yasinalp/SelfBulance/vivado/ip_repo/distance_sensor/readme.md

This IP sends a trigger signal to the distance sensors and waits for echo signals. Time elapsed from the rising edge of echo to the falling edge for each sensor is converted to distance values.
