yasinalp/SelfBulance/vivado/ip_repo/dc_motor_driver/readme.md

This IP takes an action as an input and selects appropriate pwm signals for each action.
