yasinalp/SelfBulance/design_1.pdf

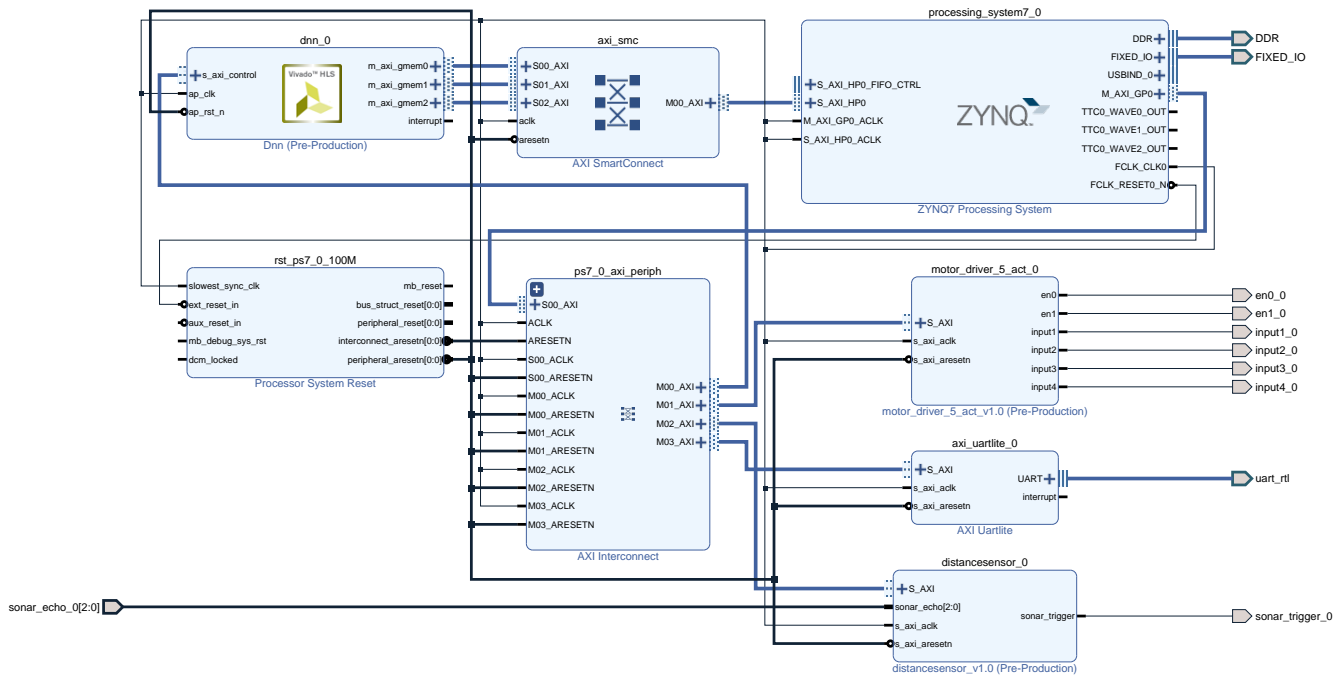
[picture p19: page 1]
DDR FIXED_IO; axi_smc; AXI SmartConnect; S00_AXI; S01_AXI; S02_AXI; M00_AXI; aclk; aresetn; axi_uartlite_0; AXI Uartlite; S_AXI; UART; s_axi_aclk; s_axi_aresetn; interrupt; distancesensor_0; distancesensor_v1.0 (Pre-Production); sonar_trigger; sonar_echo[2:0]; dnn_0; s_axi_control; m_axi_gmem0; m_axi_gmem1; m_axi_gmem2; ap_clk; ap_rst_n; en0_0 en1_0 input1_0 input2_0 input3_0 input4_0; motor_driver_5_act_0; motor_driver_5_act_v1.0 (Pre-Production); input1; input2; input3; input4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

Dnn (Pre-Production)

Processor System Reset
