yasinalp/SelfBulance/vivado/main_project/srcs/constraints/constraint_1.xdc

set_property IOSTANDARD LVCMOS33 [get_ports uart_rtl_rxd]
set_property IOSTANDARD LVCMOS33 [get_ports uart_rtl_txd]
set_property IOSTANDARD LVCMOS33 [get_ports {sonar_echo_0[0]}]
set_property IOSTANDARD LVCMOS33 [get_ports {sonar_echo_0[1]}]
set_property IOSTANDARD LVCMOS33 [get_ports {sonar_echo_0[2]}]
set_property PACKAGE_PIN Y10 [get_ports {sonar_echo_0[0]}]
set_property PACKAGE_PIN AA11 [get_ports {sonar_echo_0[1]}]
set_property PACKAGE_PIN Y11 [get_ports {sonar_echo_0[2]}]
set_property PACKAGE_PIN W12 [get_ports en0_0]
set_property PACKAGE_PIN V12 [get_ports en1_0]
set_property PACKAGE_PIN W11 [get_ports input1_0]
set_property PACKAGE_PIN V10 [get_ports input2_0]
set_property PACKAGE_PIN W10 [get_ports input3_0]
set_property PACKAGE_PIN V9 [get_ports input4_0]
set_property PACKAGE_PIN AA9 [get_ports sonar_trigger_0]
set_property PACKAGE_PIN W8 [get_ports uart_rtl_rxd]
set_property PACKAGE_PIN V8 [get_ports uart_rtl_txd]
set_property IOSTANDARD LVCMOS33 [get_ports en0_0]
set_property IOSTANDARD LVCMOS33 [get_ports en1_0]
set_property IOSTANDARD LVCMOS33 [get_ports input1_0]
set_property IOSTANDARD LVCMOS33 [get_ports input2_0]
set_property IOSTANDARD LVCMOS33 [get_ports input3_0]
set_property IOSTANDARD LVCMOS33 [get_ports input4_0]
set_property IOSTANDARD LVCMOS33 [get_ports sonar_trigger_0]
