yasinalp/SelfBulance/vivado/ip_repo/dc_motor_driver/dc_motor_driver_v1_0.vhd

library ieee;
use ieee.std_logic_1164.all;
use ieee.numeric_std.all;

entity dc_motor_driver_v1_0 is
	generic (
		-- Users to add parameters here
		pwm_0_l : integer := 100000;
        pwm_0_r : integer := 100000;
        pwm_1_l : integer := 1000;
        pwm_1_r : integer := 100000;
        pwm_2_l : integer := 100000;
        pwm_2_r : integer := 1000;
		-- User parameters ends
		-- Do not modify the parameters beyond this line


		-- Parameters of Axi Slave Bus Interface S_AXI
		C_S_AXI_DATA_WIDTH	: integer	:= 32;
		C_S_AXI_ADDR_WIDTH	: integer	:= 4
	);
	port (
		-- Users to add ports here
        en0, en1, input1, input2, input3, input4 : out std_logic;
		-- User ports ends
		-- Do not modify the ports beyond this line


		-- Ports of Axi Slave Bus Interface S_AXI
		s_axi_aclk	: in std_logic;
		s_axi_aresetn	: in std_logic;
		s_axi_awaddr	: in std_logic_vector(C_S_AXI_ADDR_WIDTH-1 downto 0);
		s_axi_awprot	: in std_logic_vector(2 downto 0);
		s_axi_awvalid	: in std_logic;
		s_axi_awready	: out std_logic;
		s_axi_wdata	: in std_logic_vector(C_S_AXI_DATA_WIDTH-1 downto 0);
		s_axi_wstrb	: in std_logic_vector((C_S_AXI_DATA_WIDTH/8)-1 downto 0);
		s_axi_wvalid	: in std_logic;
		s_axi_wready	: out std_logic;
		s_axi_bresp	: out std_logic_vector(1 downto 0);
		s_axi_bvalid	: out std_logic;
		s_axi_bready	: in std_logic;
		s_axi_araddr	: in std_logic_vector(C_S_AXI_ADDR_WIDTH-1 downto 0);
		s_axi_arprot	: in std_logic_vector(2 downto 0);
		s_axi_arvalid	: in std_logic;
		s_axi_arready	: out std_logic;
		s_axi_rdata	: out std_logic_vector(C_S_AXI_DATA_WIDTH-1 downto 0);
		s_axi_rresp	: out std_logic_vector(1 downto 0);
		s_axi_rvalid	: out std_logic;
		s_axi_rready	: in std_logic
	);
end dc_motor_driver_v1_0;

architecture arch_imp of dc_motor_driver_v1_0 is

	-- component declaration
	component dc_motor_driver_v1_0_S_AXI is
		generic (
		pwm_0_l : integer := 100000;
        pwm_0_r : integer := 100000;
        pwm_1_l : integer := 1000;
        pwm_1_r : integer := 100000;
        pwm_2_l : integer := 100000;
        pwm_2_r : integer := 1000;
		C_S_AXI_DATA_WIDTH	: integer	:= 32;
		C_S_AXI_ADDR_WIDTH	: integer	:= 4
		);
		port (
		en0, en1, input1, input2, input3, input4 : out std_logic;
		S_AXI_ACLK	: in std_logic;
		S_AXI_ARESETN	: in std_logic;
		S_AXI_AWADDR	: in std_logic_vector(C_S_AXI_ADDR_WIDTH-1 downto 0);
		S_AXI_AWPROT	: in std_logic_vector(2 downto 0);
		S_AXI_AWVALID	: in std_logic;
		S_AXI_AWREADY	: out std_logic;
		S_AXI_WDATA	: in std_logic_vector(C_S_AXI_DATA_WIDTH-1 downto 0);
		S_AXI_WSTRB	: in std_logic_vector((C_S_AXI_DATA_WIDTH/8)-1 downto 0);
		S_AXI_WVALID	: in std_logic;
		S_AXI_WREADY	: out std_logic;
		S_AXI_BRESP	: out std_logic_vector(1 downto 0);
		S_AXI_BVALID	: out std_logic;
		S_AXI_BREADY	: in std_logic;
		S_AXI_ARADDR	: in std_logic_vector(C_S_AXI_ADDR_WIDTH-1 downto 0);
		S_AXI_ARPROT	: in std_logic_vector(2 downto 0);
		S_AXI_ARVALID	: in std_logic;
		S_AXI_ARREADY	: out std_logic;
		S_AXI_RDATA	: out std_logic_vector(C_S_AXI_DATA_WIDTH-1 downto 0);
		S_AXI_RRESP	: out std_logic_vector(1 downto 0);
		S_AXI_RVALID	: out std_logic;
		S_AXI_RREADY	: in std_logic
		);
	end component dc_motor_driver_v1_0_S_AXI;

begin

-- Instantiation of Axi Bus Interface S_AXI
dc_motor_driver_v1_0_S_AXI_inst : dc_motor_driver_v1_0_S_AXI
	generic map (
	    pwm_0_l => pwm_0_l,
        pwm_0_r => pwm_0_r,
        pwm_1_l => pwm_1_l,
        pwm_1_r => pwm_1_r,
        pwm_2_l => pwm_2_l,
        pwm_2_r => pwm_2_r,
		C_S_AXI_DATA_WIDTH	=> C_S_AXI_DATA_WIDTH,
		C_S_AXI_ADDR_WIDTH	=> C_S_AXI_ADDR_WIDTH
	)
	port map (
	    en0 => en0,
	    en1 => en1,
	    input1 => input1,
	    input2 => input2,
	    input3 => input3,
	    input4 => input4,
		S_AXI_ACLK	=> s_axi_aclk,
		S_AXI_ARESETN	=> s_axi_aresetn,
		S_AXI_AWADDR	=> s_axi_awaddr,
		S_AXI_AWPROT	=> s_axi_awprot,
		S_AXI_AWVALID	=> s_axi_awvalid,
		S_AXI_AWREADY	=> s_axi_awready,
		S_AXI_WDATA	=> s_axi_wdata,
		S_AXI_WSTRB	=> s_axi_wstrb,
		S_AXI_WVALID	=> s_axi_wvalid,
		S_AXI_WREADY	=> s_axi_wready,
		S_AXI_BRESP	=> s_axi_bresp,
		S_AXI_BVALID	=> s_axi_bvalid,
		S_AXI_BREADY	=> s_axi_bready,
		S_AXI_ARADDR	=> s_axi_araddr,
		S_AXI_ARPROT	=> s_axi_arprot,
		S_AXI_ARVALID	=> s_axi_arvalid,
		S_AXI_ARREADY	=> s_axi_arready,
		S_AXI_RDATA	=> s_axi_rdata,
		S_AXI_RRESP	=> s_axi_rresp,
		S_AXI_RVALID	=> s_axi_rvalid,
		S_AXI_RREADY	=> s_axi_rready
	);

	-- Add user logic here

	-- User logic ends

end arch_imp;
