yasinalp/SelfBulance/vivado/main_project/srcs/vhdl/design_1_wrapper.vhd

--Copyright 1986-2017 Xilinx, Inc. All Rights Reserved.
----------------------------------------------------------------------------------
--Tool Version: Vivado v.2017.4 (win64) Build 2086221 Fri Dec 15 20:55:39 MST 2017
--Date        : Sun Jun 28 14:13:44 2020
--Host        : DESKTOP-37KDSCD running 64-bit major release  (build 9200)
--Command     : generate_target design_1_wrapper.bd
--Design      : design_1_wrapper
--Purpose     : IP block netlist
----------------------------------------------------------------------------------
library IEEE;
use IEEE.STD_LOGIC_1164.ALL;
library UNISIM;
use UNISIM.VCOMPONENTS.ALL;
entity design_1_wrapper is
  port (
    DDR_addr : inout STD_LOGIC_VECTOR ( 14 downto 0 );
    DDR_ba : inout STD_LOGIC_VECTOR ( 2 downto 0 );
    DDR_cas_n : inout STD_LOGIC;
    DDR_ck_n : inout STD_LOGIC;
    DDR_ck_p : inout STD_LOGIC;
    DDR_cke : inout STD_LOGIC;
    DDR_cs_n : inout STD_LOGIC;
    DDR_dm : inout STD_LOGIC_VECTOR ( 3 downto 0 );
    DDR_dq : inout STD_LOGIC_VECTOR ( 31 downto 0 );
    DDR_dqs_n : inout STD_LOGIC_VECTOR ( 3 downto 0 );
    DDR_dqs_p : inout STD_LOGIC_VECTOR ( 3 downto 0 );
    DDR_odt : inout STD_LOGIC;
    DDR_ras_n : inout STD_LOGIC;
    DDR_reset_n : inout STD_LOGIC;
    DDR_we_n : inout STD_LOGIC;
    FIXED_IO_ddr_vrn : inout STD_LOGIC;
    FIXED_IO_ddr_vrp : inout STD_LOGIC;
    FIXED_IO_mio : inout STD_LOGIC_VECTOR ( 53 downto 0 );
    FIXED_IO_ps_clk : inout STD_LOGIC;
    FIXED_IO_ps_porb : inout STD_LOGIC;
    FIXED_IO_ps_srstb : inout STD_LOGIC;
    en0_0 : out STD_LOGIC;
    en1_0 : out STD_LOGIC;
    input1_0 : out STD_LOGIC;
    input2_0 : out STD_LOGIC;
    input3_0 : out STD_LOGIC;
    input4_0 : out STD_LOGIC;
    sonar_echo_0 : in STD_LOGIC_VECTOR ( 2 downto 0 );
    sonar_trigger_0 : out STD_LOGIC;
    uart_rtl_rxd : in STD_LOGIC;
    uart_rtl_txd : out STD_LOGIC
  );
end design_1_wrapper;

architecture STRUCTURE of design_1_wrapper is
  component design_1 is
  port (
    DDR_cas_n : inout STD_LOGIC;
    DDR_cke : inout STD_LOGIC;
    DDR_ck_n : inout STD_LOGIC;
    DDR_ck_p : inout STD_LOGIC;
    DDR_cs_n : inout STD_LOGIC;
    DDR_reset_n : inout STD_LOGIC;
    DDR_odt : inout STD_LOGIC;
    DDR_ras_n : inout STD_LOGIC;
    DDR_we_n : inout STD_LOGIC;
    DDR_ba : inout STD_LOGIC_VECTOR ( 2 downto 0 );
    DDR_addr : inout STD_LOGIC_VECTOR ( 14 downto 0 );
    DDR_dm : inout STD_LOGIC_VECTOR ( 3 downto 0 );
    DDR_dq : inout STD_LOGIC_VECTOR ( 31 downto 0 );
    DDR_dqs_n : inout STD_LOGIC_VECTOR ( 3 downto 0 );
    DDR_dqs_p : inout STD_LOGIC_VECTOR ( 3 downto 0 );
    FIXED_IO_mio : inout STD_LOGIC_VECTOR ( 53 downto 0 );
    FIXED_IO_ddr_vrn : inout STD_LOGIC;
    FIXED_IO_ddr_vrp : inout STD_LOGIC;
    FIXED_IO_ps_srstb : inout STD_LOGIC;
    FIXED_IO_ps_clk : inout STD_LOGIC;
    FIXED_IO_ps_porb : inout STD_LOGIC;
    uart_rtl_rxd : in STD_LOGIC;
    uart_rtl_txd : out STD_LOGIC;
    sonar_echo_0 : in STD_LOGIC_VECTOR ( 2 downto 0 );
    sonar_trigger_0 : out STD_LOGIC;
    en0_0 : out STD_LOGIC;
    en1_0 : out STD_LOGIC;
    input1_0 : out STD_LOGIC;
    input2_0 : out STD_LOGIC;
    input3_0 : out STD_LOGIC;
    input4_0 : out STD_LOGIC
  );
  end component design_1;
begin
design_1_i: component design_1
     port map (
      DDR_addr(14 downto 0) => DDR_addr(14 downto 0),
      DDR_ba(2 downto 0) => DDR_ba(2 downto 0),
      DDR_cas_n => DDR_cas_n,
      DDR_ck_n => DDR_ck_n,
      DDR_ck_p => DDR_ck_p,
      DDR_cke => DDR_cke,
      DDR_cs_n => DDR_cs_n,
      DDR_dm(3 downto 0) => DDR_dm(3 downto 0),
      DDR_dq(31 downto 0) => DDR_dq(31 downto 0),
      DDR_dqs_n(3 downto 0) => DDR_dqs_n(3 downto 0),
      DDR_dqs_p(3 downto 0) => DDR_dqs_p(3 downto 0),
      DDR_odt => DDR_odt,
      DDR_ras_n => DDR_ras_n,
      DDR_reset_n => DDR_reset_n,
      DDR_we_n => DDR_we_n,
      FIXED_IO_ddr_vrn => FIXED_IO_ddr_vrn,
      FIXED_IO_ddr_vrp => FIXED_IO_ddr_vrp,
      FIXED_IO_mio(53 downto 0) => FIXED_IO_mio(53 downto 0),
      FIXED_IO_ps_clk => FIXED_IO_ps_clk,
      FIXED_IO_ps_porb => FIXED_IO_ps_porb,
      FIXED_IO_ps_srstb => FIXED_IO_ps_srstb,
      en0_0 => en0_0,
      en1_0 => en1_0,
      input1_0 => input1_0,
      input2_0 => input2_0,
      input3_0 => input3_0,
      input4_0 => input4_0,
      sonar_echo_0(2 downto 0) => sonar_echo_0(2 downto 0),
      sonar_trigger_0 => sonar_trigger_0,
      uart_rtl_rxd => uart_rtl_rxd,
      uart_rtl_txd => uart_rtl_txd
    );
end STRUCTURE;
